mariopin80/Solar_Pool_Heater_Controller/docs/original/pinout-arduino.txt

*INPUT*
PB1 - 4		ENTER
PB2 - 3		+
PB3 - 2		-

*OUTPUT*
AQC - 6		BOMBA DO AQUECEDOR
FIL - 5		BOMBA DE FILTRO

*DISPLAY*
RS - 8
E  - 9
D4 - 139
D5 - 12
D6 - 11
D7 - 10

*SENSORS*
TCL - A0	SENSOR DE TEMPERATURA DO COLETOR	
TPS - A1	SERSOR DE TEMPERATURA DA PISCINA
