mariopin80/Solar_Pool_Heater_Controller/docs/BOM.xlsx

Cod | Descrição | Qtd. | V. unit | V. tot
 | Atmega328P | 1 | 25.00 | 25.00
 | Cristal 16MHz | 1 | 2.90 | 2.90
 | Cristal 32.768kHz | 1 | 2.50 | 2.50
 | DS1307 | 1 | 5.16 | 5.16
 | Suporte bateria CR2032 | 1 | 1.69 | 1.69
 | Bateria CR2032 | 1 | 1.90 | 1.90
 | Chave tactil 6x6 | 3 | 0.87 | 2.61
 | Rele 5V | 2 | 4.60 | 9.20
 | Fonte Hilink | 1 | 31.80 | 31.80
 | Conectores passo 5,08 | 5 | 1.38 | 6.90
 | Display 16x2 | 1 | 20.00 | 20.00
 | Trimpot 10k | 1 | 0.50 | 0.50
 | LED 3mm | 2 | 0.20 | 0.40
 | Diodo 1N4148 | 2 | 0.10 | 0.20
 | Diodo Zener | 4 | 0.20 | 0.80
 | Resistor diverso | 6 | 0.10 | 0.60
 | Capacitor cerâmico | 2 | 0.10 | 0.20
 | Capacitor eletrolítico | 1 | 0.50 | 0.50
 | PCI (JLCPCB) | 1 | 15.60 | 15.60
 | transistor 2N3904 | 2 | 0.20 | 0.40
 | TOTAL |  |  | 128.86
 | Preço final |  |  | 412.352
