mariopin80/Solar_Pool_Heater_Controller/hardware/MPS02/2.0/esquema.pdf

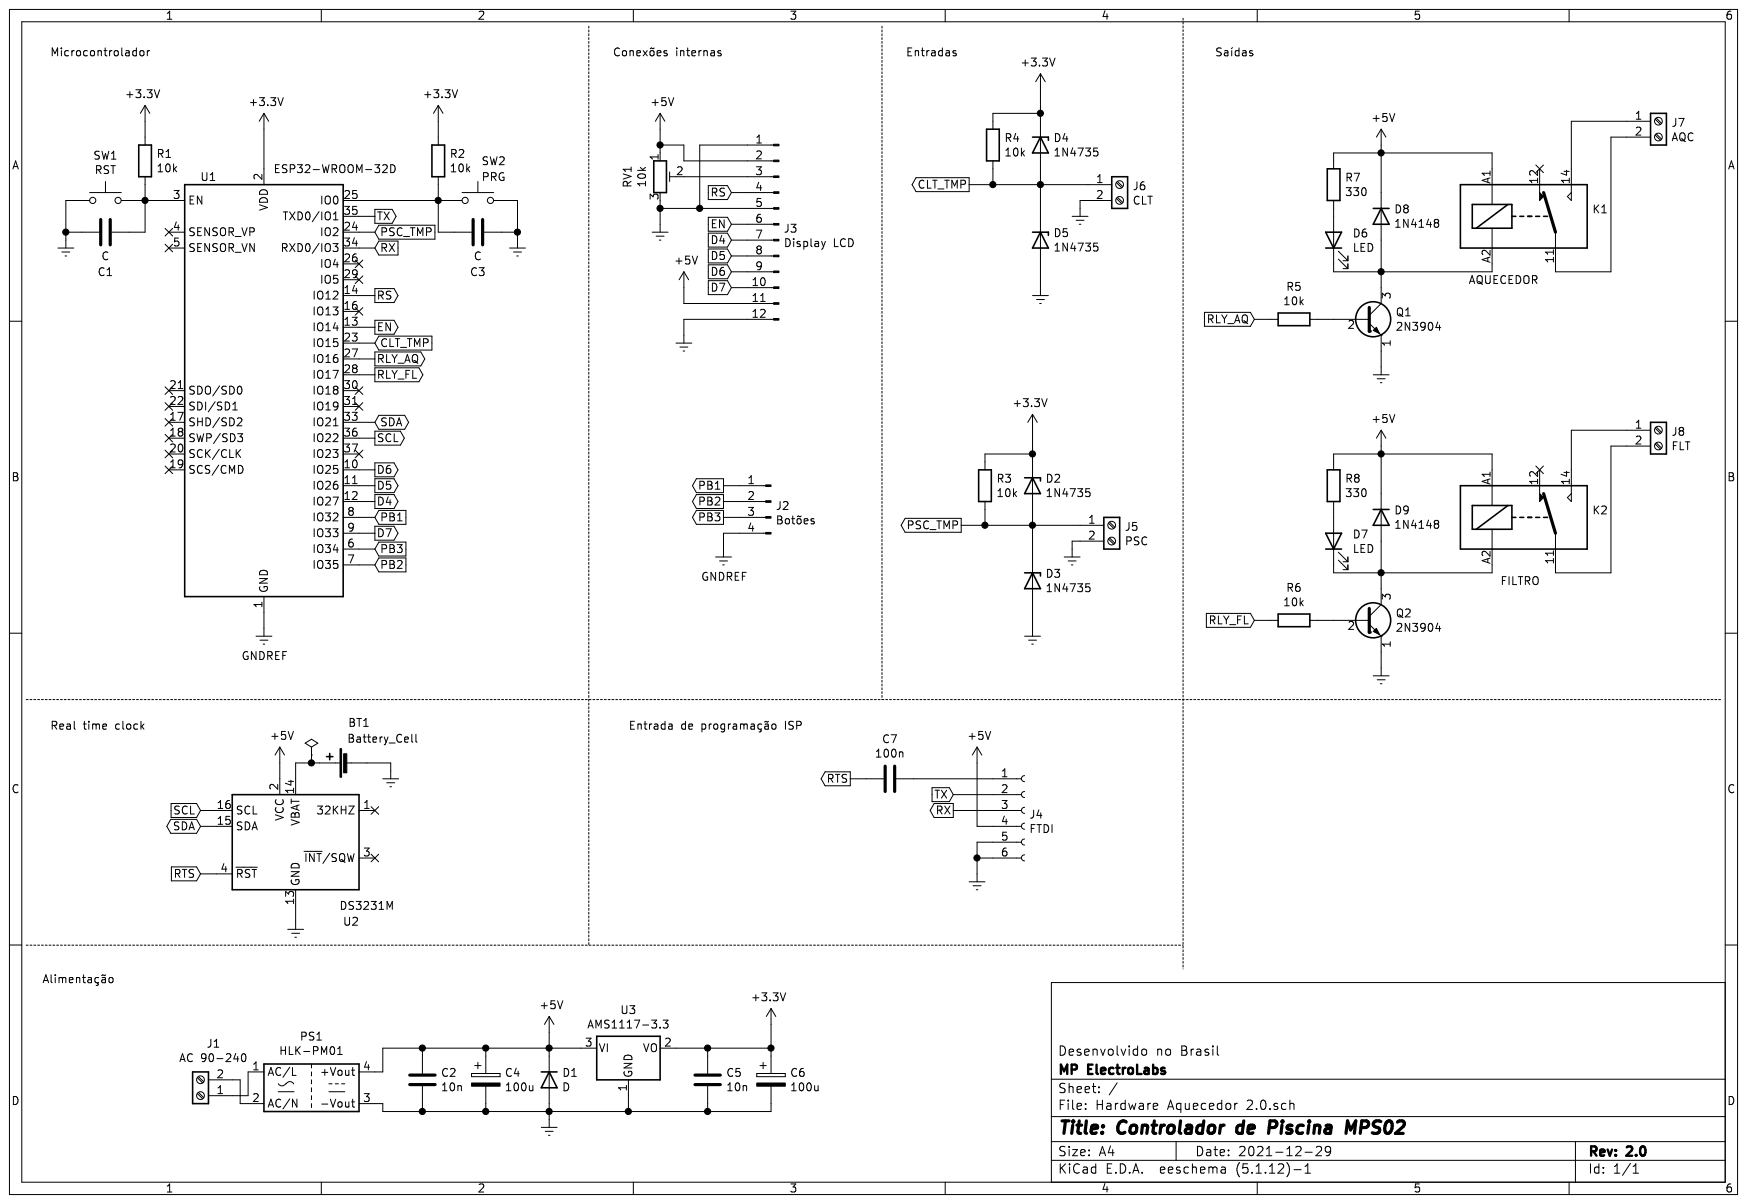
[picture p2: page 1]
