mariopin80/Solar_Pool_Heater_Controller/hardware/MPS01/1.1/Hardware Aquecedor 1.1.kicad_pcb

## KiCad design hardware/MPS01/1.1/Hardware Aquecedor 1.1.kicad_pcb (2026-11-12)

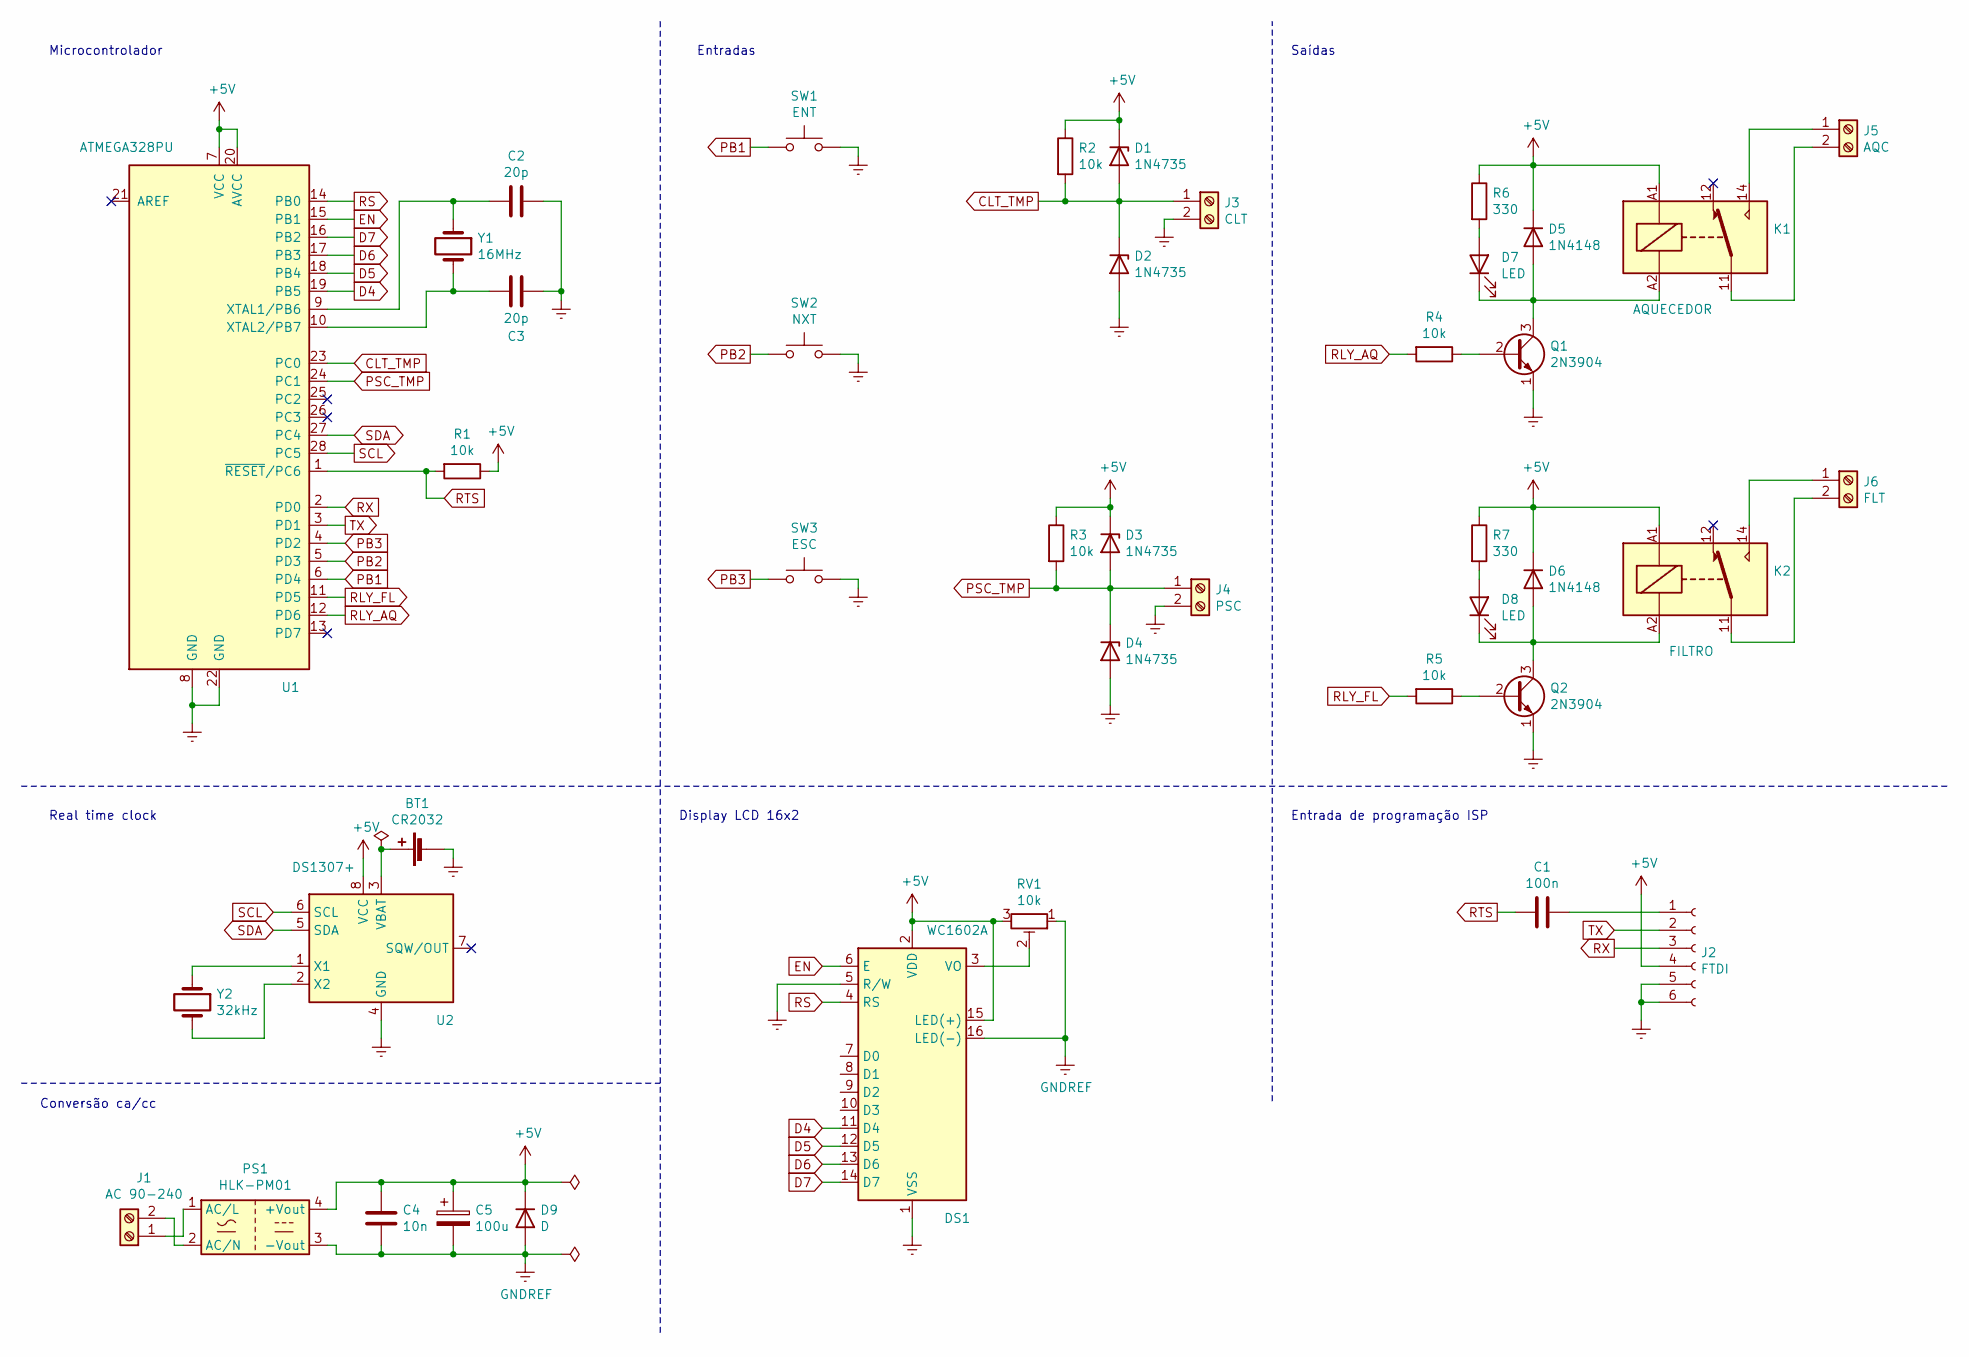
[picture p3: schematic Hardware Aquecedor 1.1.sch, Controlador de Piscina MPS01]

Parts:
BT1: CR2032; BatteryHolder_ComfortableElectronic_CH273-2450_1x2450
C1: 100n; C_Rect_L9.0mm_W2.6mm_P7.50mm_MKT
C2, C3: 20p; C_Rect_L4.0mm_W2.5mm_P2.50mm
C4: 10n; C_Rect_L9.0mm_W2.5mm_P7.50mm_MKT
C5: 100u; CP_Radial_D8.0mm_P5.00mm
D1, D2, D3, D4: 1N4735; D_A-405_P7.62mm_Horizontal
D5, D6: 1N4148; D_A-405_P7.62mm_Horizontal
D7, D8: LED; LED_D3.0mm
D9: D; D_A-405_P7.62mm_Horizontal
DS1: WC1602A
J1: AC 90-240; PhoenixContact_MSTBA_2,5_2-G-5,08_1x02_P5.08mm_Horizontal
J2: FTDI; PinHeader_1x06_P2.54mm_Vertical
J3: CLT; PhoenixContact_MSTBA_2,5_2-G-5,08_1x02_P5.08mm_Horizontal
J4: PSC; PhoenixContact_MSTBA_2,5_2-G-5,08_1x02_P5.08mm_Horizontal
J5: AQC; PhoenixContact_MSTBA_2,5_2-G-5,08_1x02_P5.08mm_Horizontal
J6: FLT; PhoenixContact_MSTBA_2,5_2-G-5,08_1x02_P5.08mm_Horizontal
K1: AQUECEDOR; Relay_SPDT_Finder_36.11
K2: FILTRO; Relay_SPDT_Finder_36.11
PS1: HLK-PM01; Converter_ACDC_HiLink_HLK-PMxx
Q1, Q2: 2N3904; TO-92_Inline
R1, R2, R3, R4, R5: 10k; R_Axial_DIN0207_L6.3mm_D2.5mm_P7.62mm_Horizontal
R6, R7: 330; R_Axial_DIN0207_L6.3mm_D2.5mm_P7.62mm_Horizontal
RV1: 10k; Potentiometer_Runtron_RM-065_Vertical
SW1: ENT; SW_PUSH_6mm
SW2: NXT; SW_PUSH_6mm
SW3: ESC; SW_PUSH_6mm
U1: ATMEGA328PU; DIP-28_W7.62mm_LongPads
U2: DS1307+; DIP-8_W7.62mm
Y1: 16MHz; Crystal_HC49-4H_Vertical
Y2: 32kHz; Crystal_C26-LF_D2.1mm_L6.5mm_Horizontal

Connections:
+5V: C4.1, C5.1, D1.1 (K), D3.1 (K), D5.1 (K), D6.1 (K), D9.1 (K), DS1.2 (VDD), DS1.15 (LED(+)), J2.4, K1.A1, K2.A1, PS1.4 (+Vout), R1.1, R2.1, R3.1, R6.1, R7.1, RV1.3, U1.7 (VCC), U1.20 (AVCC), U2.8 (VCC)
CLT_TMP: D1.2 (A), D2.1 (K), J3.1, R2.2, U1.23 (PC0)
D4: DS1.11 (D4), U1.19 (PB5)
D5: DS1.12 (D5), U1.18 (PB4)
D6: DS1.13 (D6), U1.17 (PB3)
D7: DS1.14 (D7), U1.16 (PB2)
EN: DS1.6 (E), U1.15 (PB1)
GNDREF: BT1.2 (-), C2.1, C3.1, C4.2, C5.2, D2.2 (A), D4.2 (A), D9.2 (A), DS1.1 (VSS), DS1.5 (R/W), DS1.16 (LED(-)), J2.5, J2.6, J3.2, J4.2, PS1.3 (-Vout), Q1.1 (E), Q2.1 (E), RV1.1, SW1.2, SW2.2, SW3.2, U1.8 (GND), U1.22 (GND), U2.4 (GND)
unnamed: BT1.1 (+), U2.3 (VBAT)
unnamed: C1.1, J2.1
unnamed: C2.2, U1.9 (XTAL1/PB6), Y1.1
unnamed: C3.2, U1.10 (XTAL2/PB7), Y1.2
unnamed: D5.2 (A), D7.1 (K), K1.A2, Q1.3 (C)
unnamed: D6.2 (A), D8.1 (K), K2.A2, Q2.3 (C)
unnamed: D7.2 (A), R6.2
unnamed: D8.2 (A), R7.2
unnamed: DS1.3 (VO), RV1.2
unnamed: J1.1, PS1.1 (AC/L)
unnamed: J1.2, PS1.2 (AC/N)
unnamed: J5.1, K1.14
unnamed: J5.2, K1.11
unnamed: J6.1, K2.14
unnamed: J6.2, K2.11
unnamed: Q1.2 (B), R4.1
unnamed: Q2.2 (B), R5.1
unnamed: U2.1 (X1), Y2.1
unnamed: U2.2 (X2), Y2.2
PB1: SW1.1, U1.6 (PD4)
PB2: SW2.1, U1.5 (PD3)
PB3: SW3.1, U1.4 (PD2)
PSC_TMP: D3.2 (A), D4.1 (K), J4.1, R3.2, U1.24 (PC1)
RLY_AQ: R4.2, U1.12 (PD6)
RLY_FL: R5.2, U1.11 (PD5)
RS: DS1.4 (RS), U1.14 (PB0)
RTS: C1.2, R1.2, U1.1 (~RESET~/PC6)
RX: J2.3, U1.2 (PD0)
SCL: U1.28 (PC5), U2.6 (SCL)
SDA: U1.27 (PC4), U2.5 (SDA)
TX: J2.2, U1.3 (PD1)

Notes on the sheet:
Microcontrolador
Entradas
Saídas
Entrada de programação ISP
Real time clock
Display LCD 16x2
Conversão ca/cc

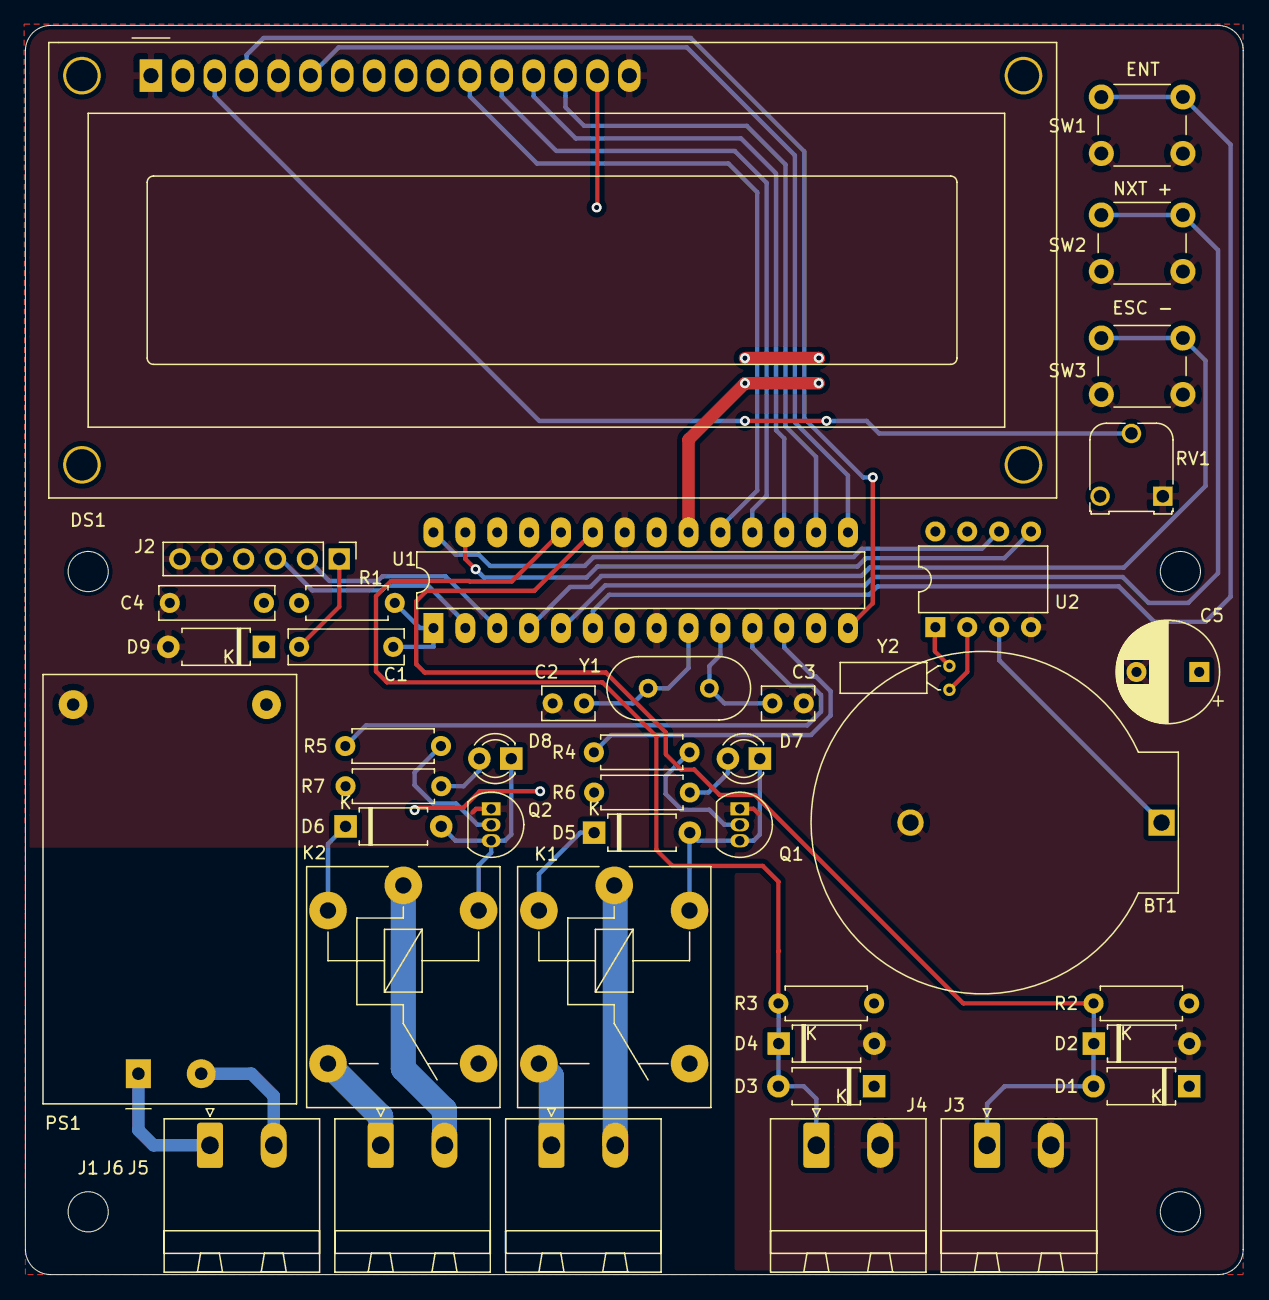
[picture p4: board Hardware Aquecedor 1.1.kicad_pcb from above]

Board: 2 copper layers, 97.0 x 99.5 mm, 42 parts (0 on the bottom side), 39 nets.
