mariopin80/Solar_Pool_Heater_Controller/hardware/MPS02/2.0/Hardware Aquecedor 2.0.kicad_pcb

## KiCad design hardware/MPS02/2.0/Hardware Aquecedor 2.0.kicad_pcb (2026-11-12)

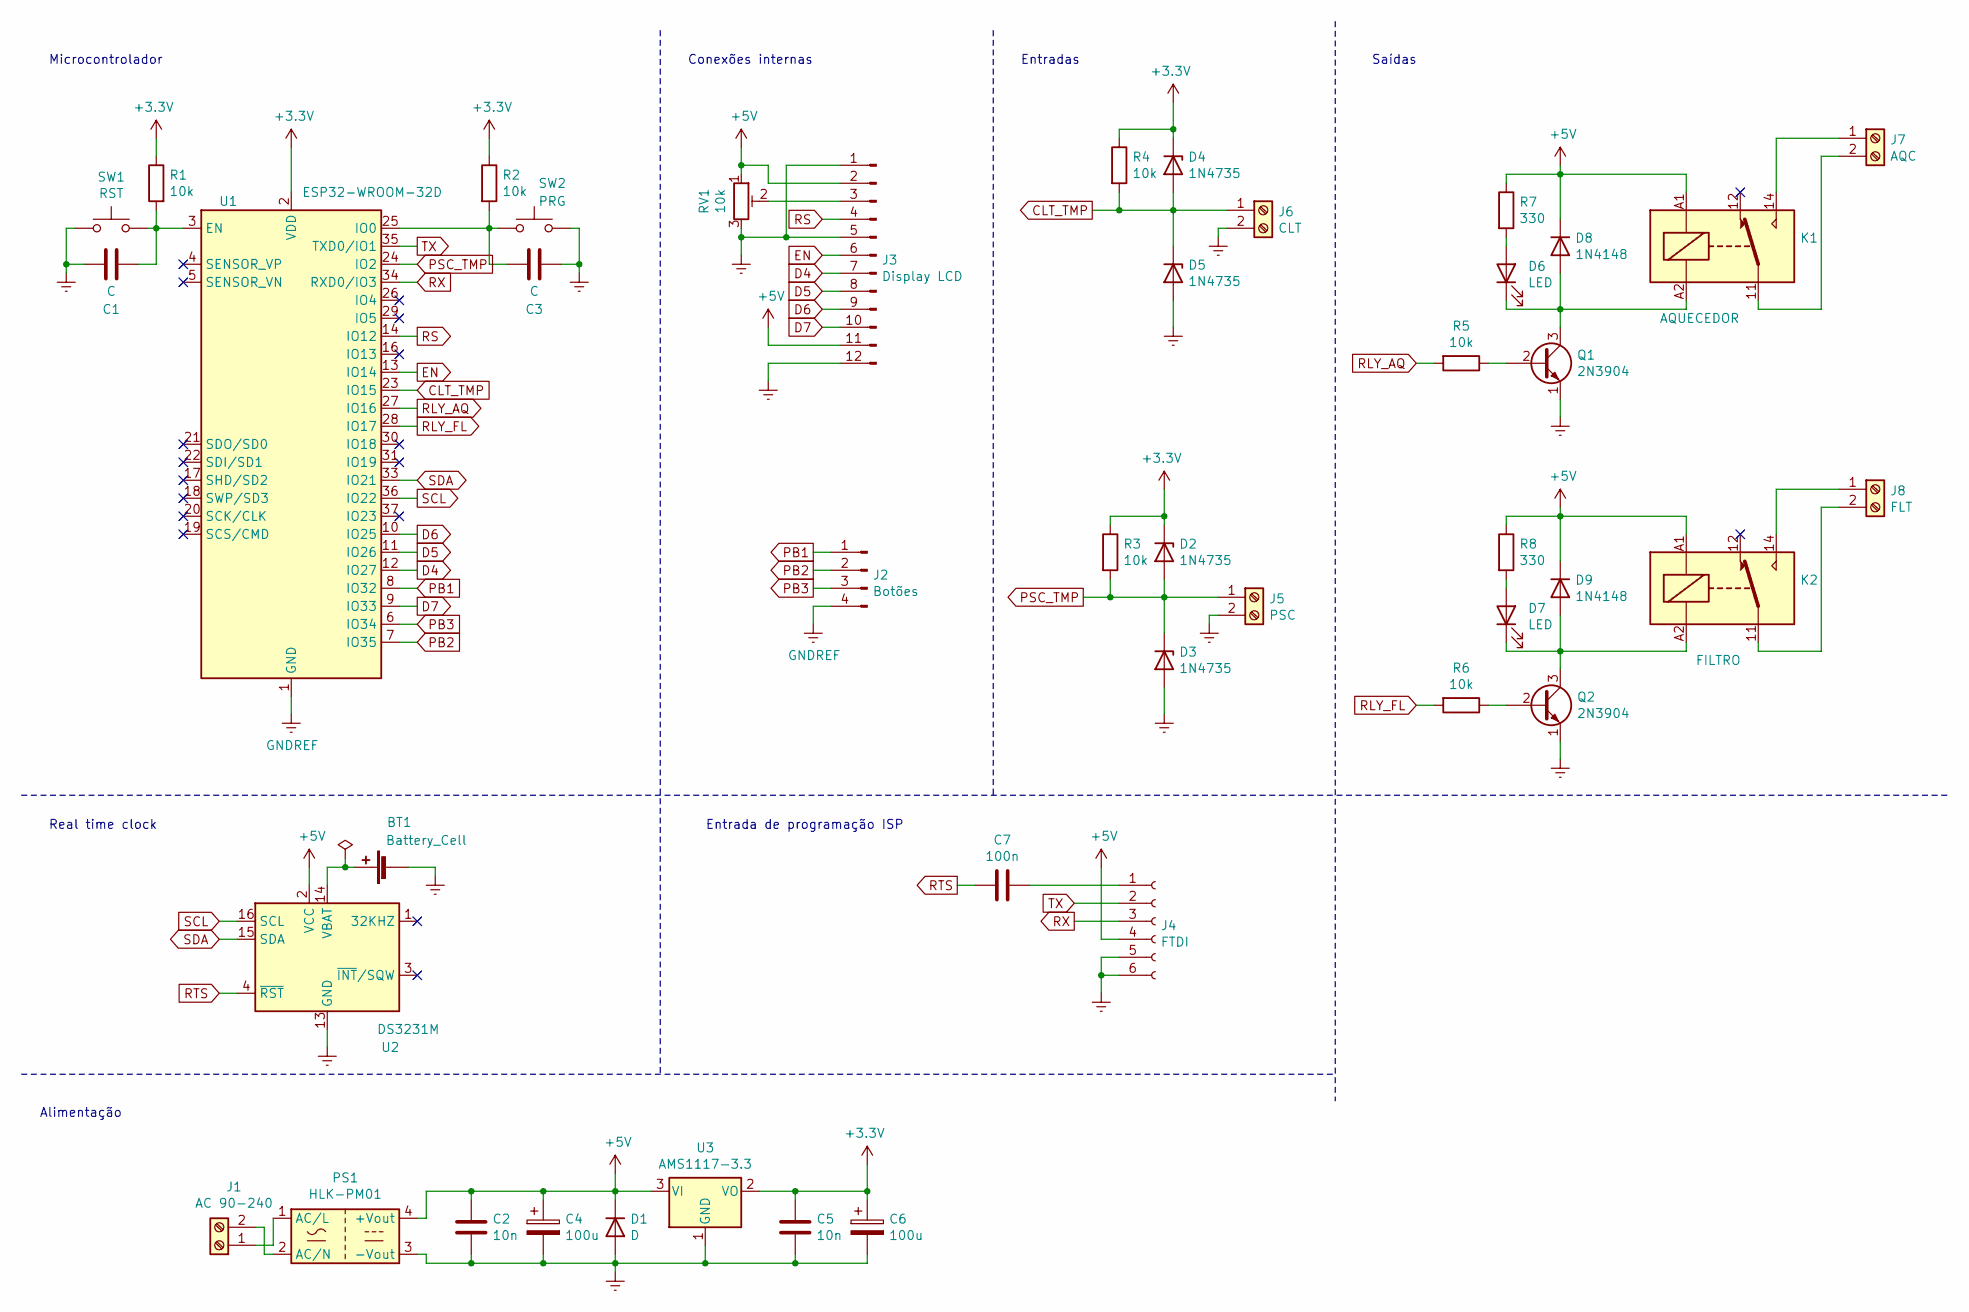
[picture p5: schematic Hardware Aquecedor 2.0.sch, Controlador de Piscina MPS02]

Parts:
BT1: Battery_Cell; BatteryHolder_Keystone_103_1x20mm
C1, C3: C; C_0805_2012Metric_Pad1.18x1.45mm_HandSolder
C2, C5: 10n; C_0805_2012Metric_Pad1.18x1.45mm_HandSolder
C4, C6: 100u; CP_Radial_D6.3mm_P2.50mm
C7: 100n; C_0805_2012Metric_Pad1.18x1.45mm_HandSolder
D1: D; D_A-405_P7.62mm_Horizontal
D2, D3, D4, D5: 1N4735; D_A-405_P7.62mm_Horizontal
D6, D7: LED; LED_D3.0mm
D8, D9: 1N4148; D_A-405_P7.62mm_Horizontal
J1: AC 90-240; PhoenixContact_MC_1,5_2-G-5.08_1x02_P5.08mm_Horizontal
J2: Botões; JST_XH_B4B-XH-A_1x04_P2.50mm_Vertical
J3: Display LCD; JST_XH_B12B-XH-A_1x12_P2.50mm_Vertical
J4: FTDI; PinHeader_1x06_P2.54mm_Vertical
J5: PSC; PhoenixContact_MC_1,5_2-G-5.08_1x02_P5.08mm_Horizontal
J6: CLT; PhoenixContact_MC_1,5_2-G-5.08_1x02_P5.08mm_Horizontal
J7: AQC; PhoenixContact_MC_1,5_2-G-5.08_1x02_P5.08mm_Horizontal
J8: FLT; PhoenixContact_MC_1,5_2-G-5.08_1x02_P5.08mm_Horizontal
K1: AQUECEDOR; Relay_SPDT_Finder_36.11
K2: FILTRO; Relay_SPDT_Finder_36.11
PS1: HLK-PM01; Converter_ACDC_HiLink_HLK-PMxx
Q1, Q2: 2N3904; TO-92_Inline
R1, R2, R3, R4, R5, R6: 10k; R_0805_2012Metric_Pad1.20x1.40mm_HandSolder
R7, R8: 330; R_0805_2012Metric_Pad1.20x1.40mm_HandSolder
RV1: 10k; Potentiometer_Runtron_RM-065_Vertical
SW1: RST; SW_PUSH_6mm
SW2: PRG; SW_PUSH_6mm
U1: ESP32-WROOM-32D; ESP32-WROOM-32
U2: DS3231M; SOIC-16W_7.5x10.3mm_P1.27mm
U3: AMS1117-3.3; SOT-223-3_TabPin2

Connections:
+3V3: C5.1, C6.1, D2.1 (K), D4.1 (K), R1.1, R2.1, R3.1, R4.1, U1.2 (VDD), U3.2 (VO)
+5V: C2.1, C4.1, D1.1 (K), D8.1 (K), D9.1 (K), J3.2, J3.11, J4.4, K1.A1, K2.A1, PS1.4 (+Vout), R7.1, R8.1, RV1.1, U2.2 (VCC), U3.3 (VI); also elsewhere on the board
CLT_TMP: D4.2 (A), D5.1 (K), J6.1, R4.2, U1.23 (IO15)
D4: J3.7, U1.12 (IO27); also elsewhere on the board
D5: J3.8, U1.11 (IO26); also elsewhere on the board
D6: J3.9, U1.10 (IO25); also elsewhere on the board
D7: J3.10, U1.9 (IO33); also elsewhere on the board
EN: J3.6, U1.13 (IO14); also elsewhere on the board
GNDREF: BT1.2 (-), C1.1, C2.2, C3.1, C4.2, C5.2, C6.2, D1.2 (A), D3.2 (A), D5.2 (A), J2.4, J3.1, J3.5, J3.12, J4.5, J4.6, J5.2, J6.2, PS1.3 (-Vout), Q1.1 (E), Q2.1 (E), RV1.3, SW1.2, SW2.2, U1.1 (GND), U1.15 (GND), U1.38 (GND), U1.39 (GND), U2.5 (GND), U2.6 (GND), U2.7 (GND), U2.8 (GND), U2.9 (GND), U2.10 (GND), U2.11 (GND), U2.12 (GND), U2.13 (GND), U3.1 (GND); also elsewhere on the board
unnamed: BT1.1 (+), U2.14 (VBAT)
unnamed 10: C1.2, R1.2, SW1.1, U1.3 (EN); also elsewhere on the board
unnamed 11: C3.2, R2.2, SW2.1, U1.25 (IO0); also elsewhere on the board
unnamed: C7.1, J4.1
unnamed: D6.1 (K), D8.2 (A), K1.A2, Q1.3 (C)
unnamed: D6.2 (A), R7.2
unnamed: D7.1 (K), D9.2 (A), K2.A2, Q2.3 (C)
unnamed: D7.2 (A), R8.2
unnamed: J1.1, PS1.1 (AC/L)
unnamed: J1.2, PS1.2 (AC/N)
unnamed 19: J3.3, RV1.2; also elsewhere on the board
unnamed: J7.1, K1.14
unnamed: J7.2, K1.11
unnamed: J8.1, K2.14
unnamed: J8.2, K2.11
unnamed: Q1.2 (B), R5.1
unnamed: Q2.2 (B), R6.1
PB1: J2.1, U1.8 (IO32); also elsewhere on the board
PB2: J2.2, U1.7 (IO35); also elsewhere on the board
PB3: J2.3, U1.6 (IO34); also elsewhere on the board
PSC_TMP: D2.2 (A), D3.1 (K), J5.1, R3.2, U1.24 (IO2)
RLY_AQ: R5.2, U1.27 (IO16)
RLY_FL: R6.2, U1.28 (IO17)
RS: J3.4, U1.14 (IO12); also elsewhere on the board
RTS: C7.2, U2.4 (~RST)
RX: J4.3, U1.34 (RXD0/IO3)
SCL: U1.36 (IO22), U2.16 (SCL)
SDA: U1.33 (IO21), U2.15 (SDA)
TX: J4.2, U1.35 (TXD0/IO1)

Notes on the sheet:
Microcontrolador
Entradas
Saídas
Entrada de programação ISP
Real time clock
Conexões internas
Alimentação

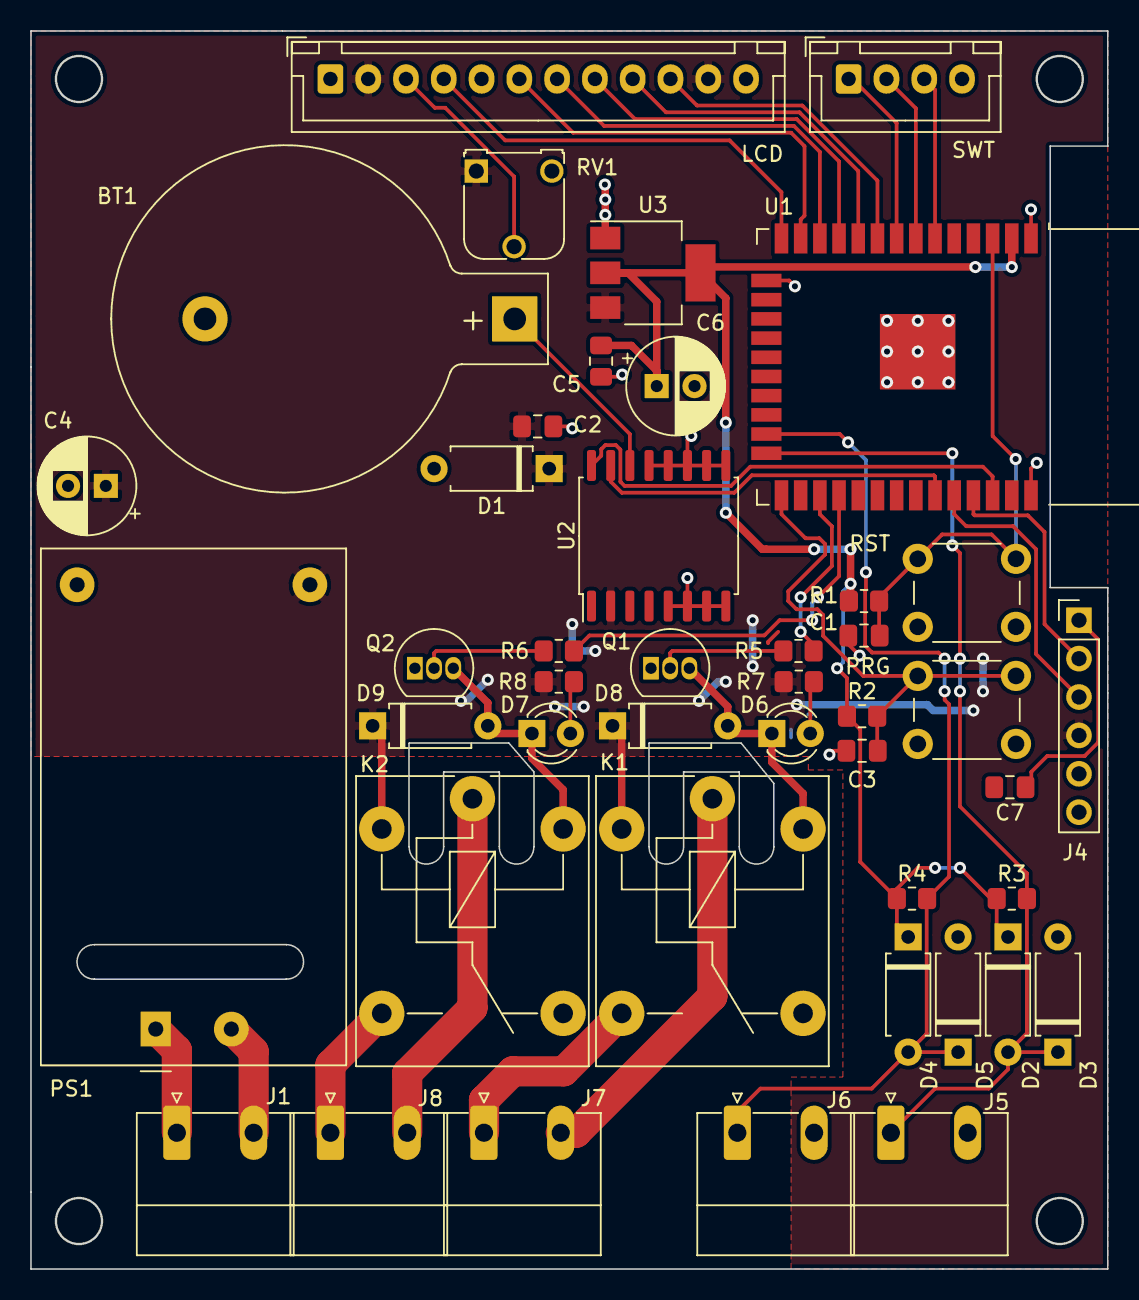
[picture p6: board Hardware Aquecedor 2.0.kicad_pcb from above]

Board: 2 copper layers, 71.2 x 81.9 mm, 44 parts (0 on the bottom side), 38 nets.

Other parts of the board:
LCD: Display LCD; JST_XH_B12B-XH-A_1x12_P2.50mm_Vertical
PRG: PRG; SW_PUSH_6mm
RST: RST; SW_PUSH_6mm
SWT: Botões; JST_XH_B4B-XH-A_1x04_P2.50mm_Vertical

Their connections:
+5V: LCD.2, LCD.11; also elsewhere on the board
D4: LCD.7; also elsewhere on the board
D5: LCD.8; also elsewhere on the board
D6: LCD.9; also elsewhere on the board
D7: LCD.10; also elsewhere on the board
EN: LCD.6; also elsewhere on the board
GNDREF: LCD.1, LCD.5, LCD.12, PRG.2, RST.2, SWT.4; also elsewhere on the board
unnamed 10: RST.1; also elsewhere on the board
unnamed 11: PRG.1; also elsewhere on the board
unnamed 19: LCD.3; also elsewhere on the board
PB1: SWT.1; also elsewhere on the board
PB2: SWT.2; also elsewhere on the board
PB3: SWT.3; also elsewhere on the board
RS: LCD.4; also elsewhere on the board
