mariopin80/Solar_Pool_Heater_Controller/(commit log)

2026-11-12 Document the solar pool heater controller
2026-11-12 Archive KiCad designs and document the MPS01 controller
    [BOM.xlsx, Hardware Aquecedor 1.1.kicad_pcb, Hardware Aquecedor 1.1.sch, Hardware Aquecedor 2.0.kicad_pcb, Hardware Aquecedor 2.0.sch, Hardware Aquecedor v2.kicad_pcb, Hardware Aquecedor.kicad_pcb, Hardware Aquecedor.sch]
2026-11-12 Import MPS01 firmware v0.0.1
    Initial prototype
    Initial LCD interface, temperature display, pump outputs and EEPROM settings.
    The sketch references DS1307 without including RTC.h and uses an undeclared `segundo` variable.
2026-11-12 Import MPS01 firmware v0.0.2
    Differential heating control
    First minimally functional heater control, with independent differential start and stop thresholds and fixed collector temperature limits.
    Adds the NTC conversion for the pool channel and retains a linear conversion for the collector channel.
    [PoolHeater.ino]
2026-11-12 Import MPS01 firmware v0.0.3
    Sensor offsets
    Adds separate calibration offsets for the pool and collector readings, editable in the technical menu and stored in EEPROM.
2026-11-12 Import MPS01 firmware v0.0.6
    PCB pin mapping and timed filtration
    Reassigns the buttons, relay outputs and LCD pins and applies the filter schedule to the output.
    Converts both sensor channels as NTC dividers using the PCB's resistor arrangement.
    The original notes record early tests with the first PCB and a wiring workaround for reversed RTC SDA/SCL. The MPS01 1.1 layout corrects that routing.
    [PoolHeater.ino]
2026-11-12 Import MPS01 firmware v0.1.0
    MVP and manual pump modes
    Original MVP milestone. Adds independent automatic, forced-on and forced-off modes for the heater and filter pumps and persists them in EEPROM.
2026-11-12 Import MPS01 firmware v0.1.1
    Circulation menu prototype
    Adds early daily circulation menu states and names the LCD pin constants. The circulation menu reuses the two filter schedule slots.
    The original notes mention RTC drift compensation. The seconds adjustment in the supplied sketch is commented out.
    The source header and boot screen still show `0.1.0`.
    [PoolHeater.ino]
2026-11-12 Import MPS01 firmware v0.2.0
    Independent circulation schedule
    Adds a separate schedule for heating-loop circulation and combines it with temperature demand in automatic mode.
    Starts the RTC on each boot and changes the fixed collector overtemperature threshold to 65 °C.
    [PoolHeater.ino]
2026-11-12 Import MPS01 firmware v0.2.1
    Adjustable collector limits
    Adds adjustable anti-ice and overtemperature thresholds in EEPROM, with `ICE` and `OVH` indicators.
    Retains heating and circulation demand between updates and adds return margins around the collector limits.
2026-11-12 Import MPS01 firmware v0.2.1b
    Sensor averaging and differential fix
    Averages 50 ADC samples per sensor, blinks `ICE` and `OVH`, and corrects the differential shutoff comparison.
    The original folder identifies the `b` revision. The header and boot screen still show `0.2.1`.
    [PoolHeater.ino]
2026-11-12 Import MPS01 firmware v0.2.2
    Software UART preparation
    Initializes a 9600 baud software UART on A2/A3 for a serial Bluetooth module.
    Uses a shared minutes-since-midnight value for both schedules.
2026-11-12 Import MPS01 firmware v0.3.0_BT
    Bluetooth control experiment
    Adds serial commands `1`–`6` for both pumps and `7` for the two temperature readings. Shortens menu delays.
    Known issue: filter commands `4`–`6` write the heater mode to the filter's EEPROM address. The front panel writes the filter mode correctly.
    The `_BT` suffix comes from the original folder. The header and boot screen show `0.3.0`.
    [PoolHeater.ino]
2026-11-12 Record Arduino Uno build verification
